Gyrohammer/KGM/docs/hardware.md

## [Raspi Camera](https://www.printables.com/model/389706-anycubic-kobra-go-camera-mount){target=_blank}
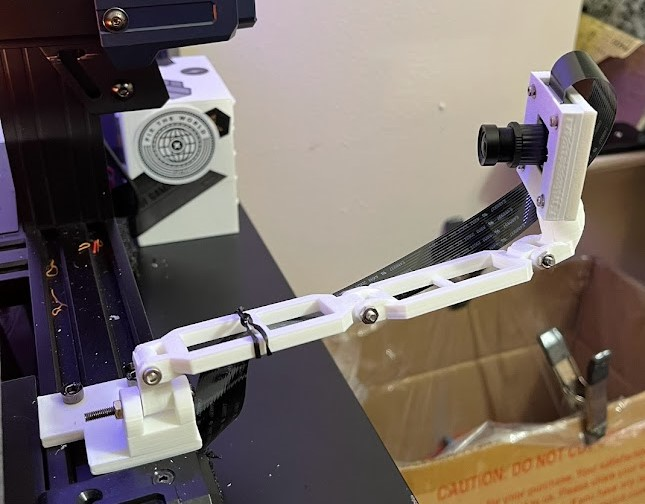
[picture p1: docs/assets/camera.jpg]
Raspi Camera


## [Hero Me Gen. 7.1](https://www.printables.com/model/39322-hero-me-gen6-master-suite){target=_blank}
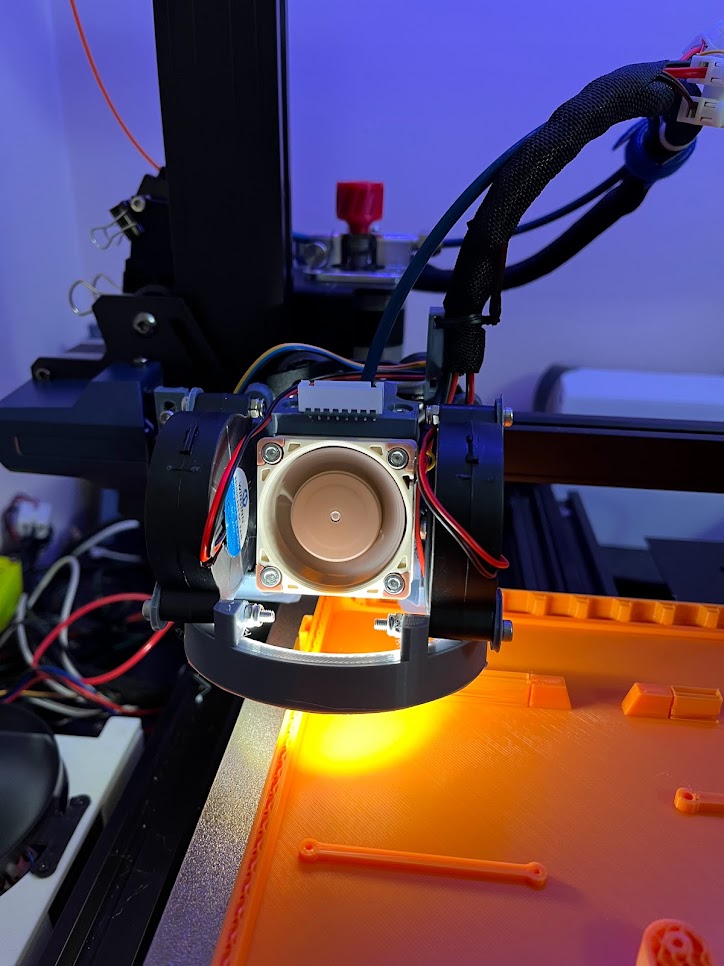
[picture p2: docs/assets/heromeg7.1.jpg]
HMG7.1


## [BTT SKR 3](https://www.printables.com/model/389719-btt-skr3-case){target=_blank}
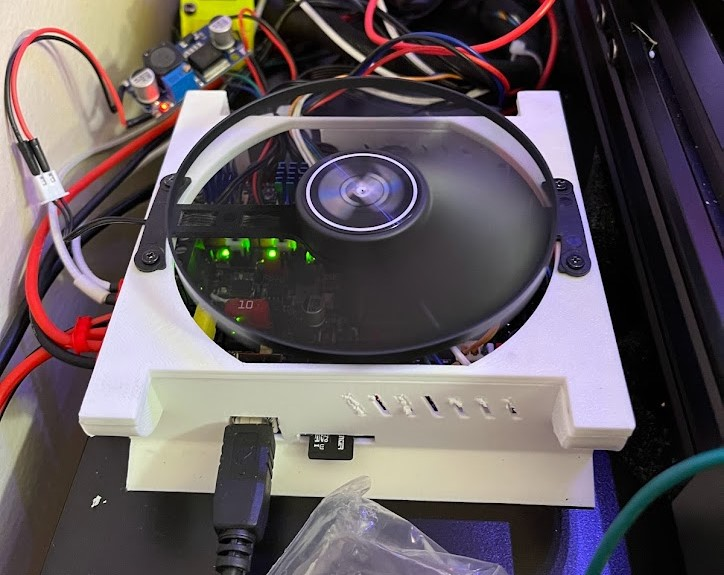
[picture p3: docs/assets/motherboard.jpg]
motherboard case
