Gyrohammer/KGM/docs/index.md

# Welcome to My Mod Page!
## Intro

I decided to make a website to showcase my Kobra Go and the mods I've performed to it.

I'll be keeping this up to date to the best of my ability!

## **Recommended Order of Modifications**

### [Klipper](software/klipper.md)
This upgrade can be performed on a stock machine, making it one of the most cost efficient upgrades.
### [Direct Drive](mods/orbiter-2.md)
Cost and time will be the biggest sinks here, as wires will need to be extended and crimped. The cost also increases as a DD extruder must be obtained. 
### [Enclosure](mods/enclosure.md)
The highest cost and time sink. Lots of components will be needed and lots of wires extended.

## Current Status
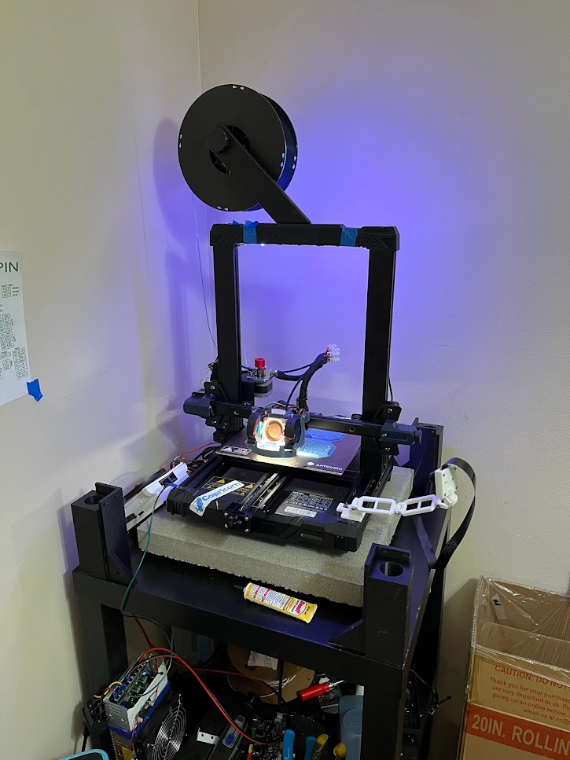
[picture p4: docs/assets/feb23setup.jpg]
January '24 Setup


* Software: 
    ```Klipper```
* Mainboard:
    ```BTT SKR 3.0 + Raspi 4 4GB```
* Drivers:
    ```TMC2209```
* Stepper Motors:
    ```Stock```
* Hotend:
    ```Microswiss```
* Extruder:
    ```Orbiter 2.0```
* Printhead:
    ```Endli Orbiter 2.0```
* Cooling: 
    
    ```Arctic S4023-15k```

    ```Single 5015```
