Gyrohammer/KGM/docs/mods/belted-z-axis.md

# NOTE: THESE LINKS ARE PART OF THE AMAZON ASSOCIATES PROGRAM OF WHICH I AM IN. BY USING THESE LINKS TO PURCHASE PRODUCTS, YOU HELP ME EARN A SMALL COMISSION. THANKS!

# [Belted Z-Axis](https://kevinakasam.com/belt-driven-ender-3/){target=_blank}

This belted z-axis mod from Kevin is one of the more involved upgrades one can perform on a Kobra Go. It involves replacing the two rear brackets with some 3D printed ones which then have to be modified to fit the eccentric nut that the Go uses. The crossbar of the frame must also be removed and replaced with a standard 2020 aluminum extrusion. 

## Replacing the Crossbar

In order to replace the crossbar one must obtain some [2020 aluminum extrusion](https://amzn.to/4ayI8oi){target=_blank}. A single extrusion must then be cut to 330mm in length, and holes drilled through the top to secure it onto the frame. I used a drill press at work, and made [a stencil](../assets/crossbarmod-stencil.stl) to get the holes correct.

<!-- Import the component -->
<script type="module" src="../assets/javascript/model-viewer.js"></script>

<!-- Use it like any other HTML element -->
<model-viewer style="width: 100%; height: 400px; top: 0px;  position: sticky" alt="Crossbar Stencil" auto-rotate src="../assets/3d-models/crossbar-stencil.glb" ar environment-image="" poster="" shadow-intensity="1" camera-controls touch-action="" loading="eager" render-scale=0.5 ></model-viewer>

After this modification is complete, just follow the steps outlined in the guide on Kevins website! Oh also be sure to order one of the kits from the vendors he recommends! I ordered mine from DFH and had a good experience.
