Gyrohammer/KGM/docs/assets/dialgaugebracket2.jpg

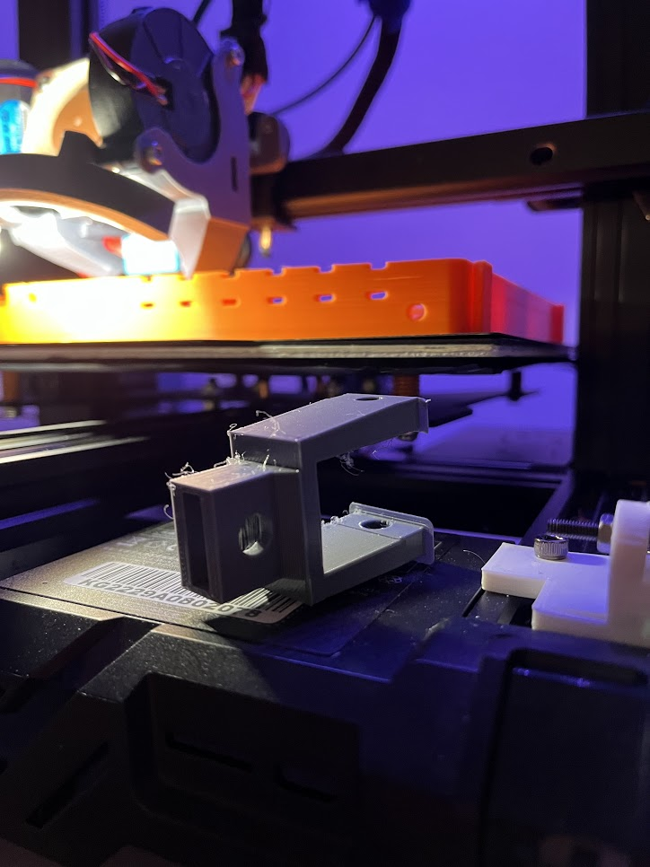
docs/assets/dialgaugebracket2.jpg
