Gyrohammer/KGM/docs/assets/dialgaugebracket3.jpg

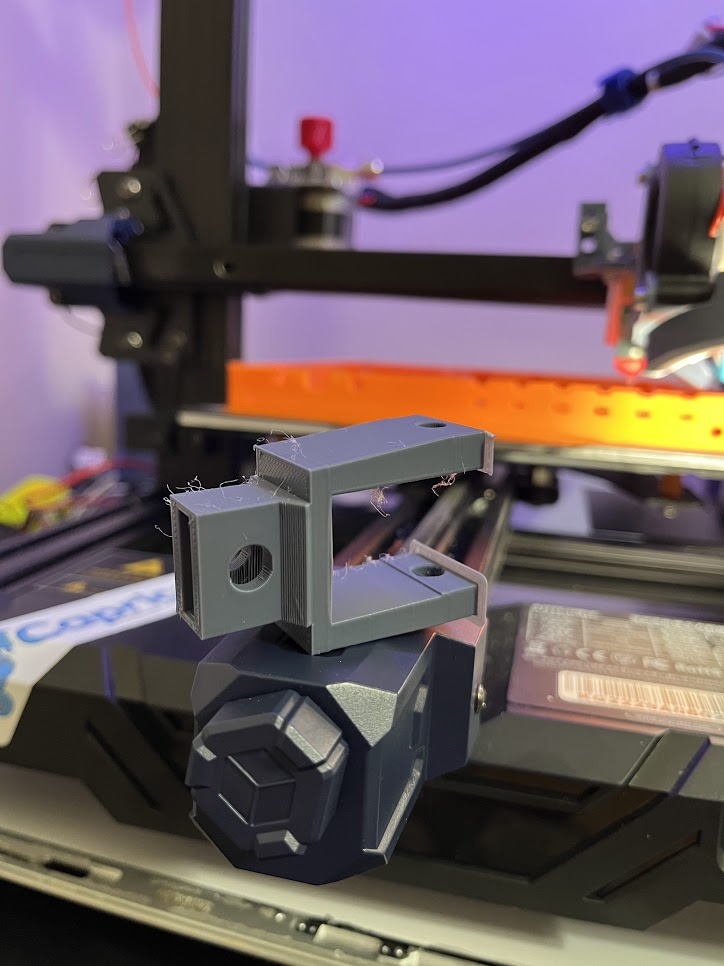
docs/assets/dialgaugebracket3.jpg
