Gyrohammer/KGM/docs/assets/dialgaugebracket.jpg

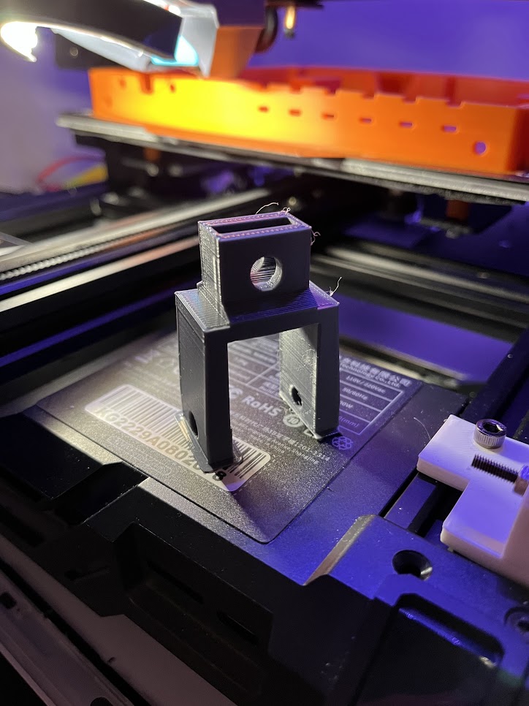
docs/assets/dialgaugebracket.jpg
