Gyrohammer/KGM/docs/assets/first_benchy.jpg

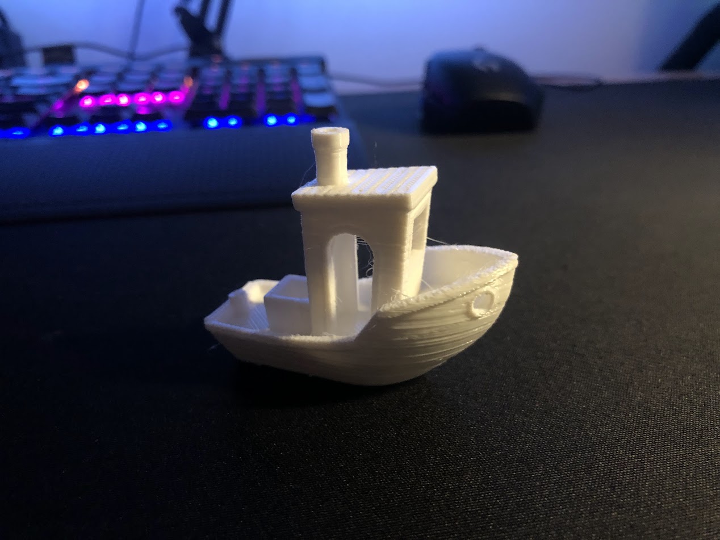
docs/assets/first_benchy.jpg
