Gyrohammer/KGM/docs/mods/assets/hmg7.jpg

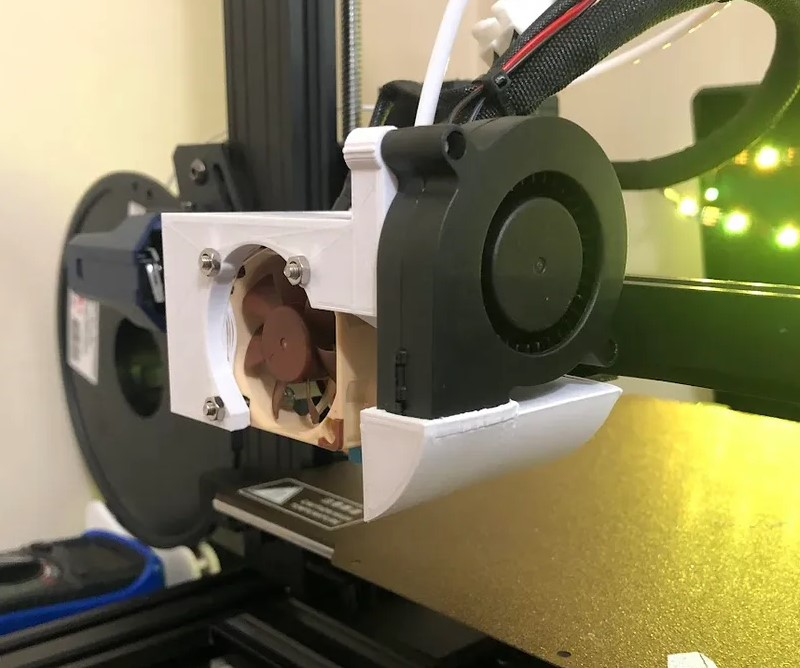
docs/mods/assets/hmg7.jpg
