Gyrohammer/KGM/site/accessories/assets/heromeg7.1.jpg

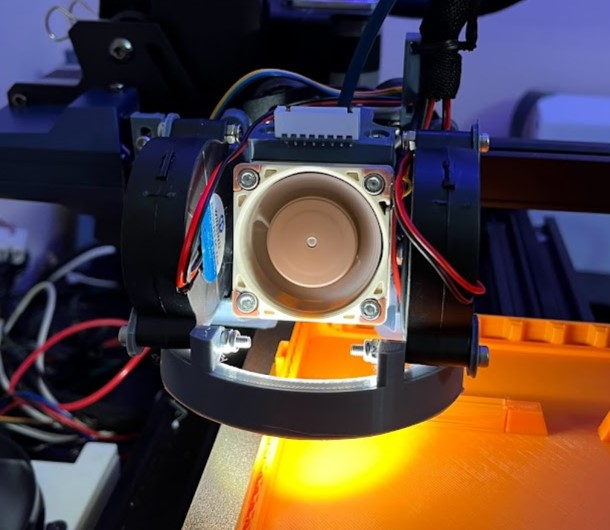
site/accessories/assets/heromeg7.1.jpg
