Gyrohammer/KGM/site/assets/bench_new_front_iso.jpg

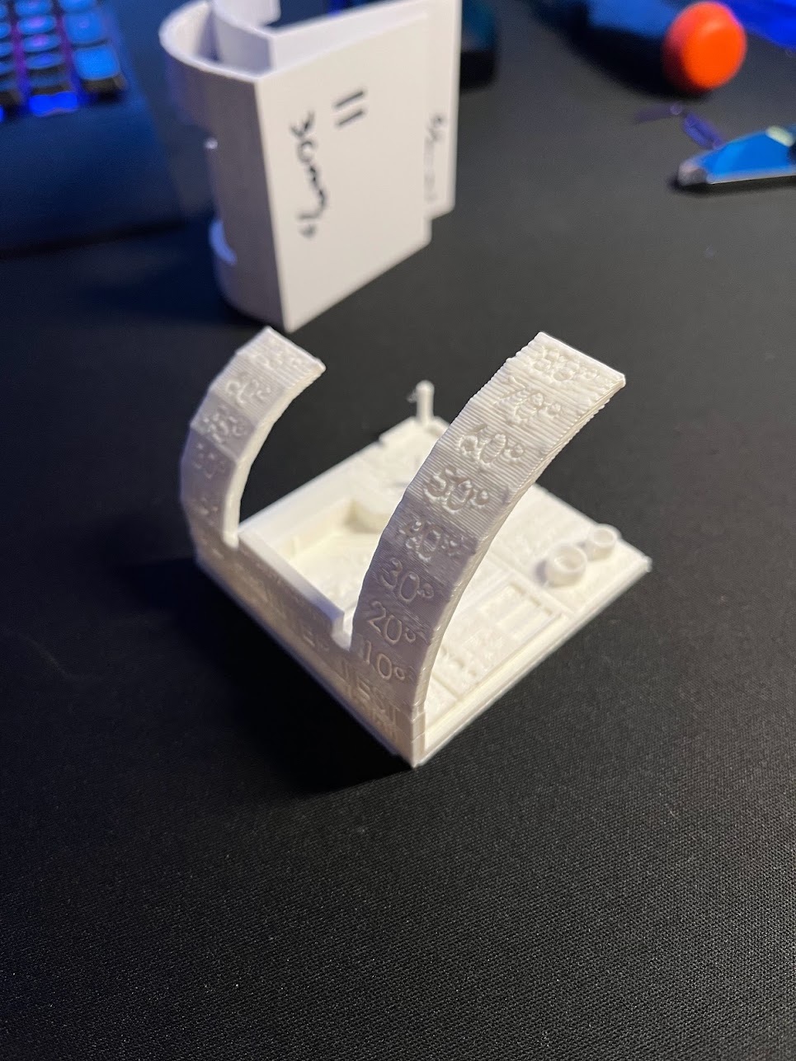
site/assets/bench_new_front_iso.jpg
