Gyrohammer/KGM/docs/assets/3d-models/enclosure/Vents/Exhaust Filtered/Main Body.stl

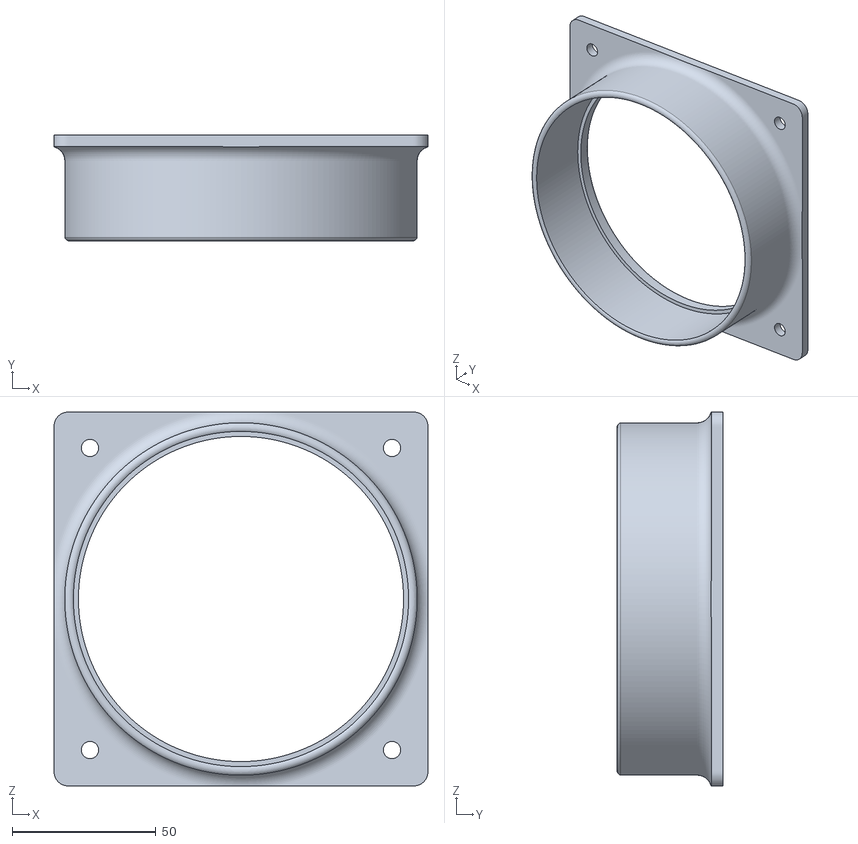
[picture p16: CAD file, 2023-12-27]
docs/assets/3d-models/enclosure/Vents/Exhaust Filtered/Main Body.stl
130.0 x 36.9 x 130.0
