Gyrohammer/KGM/docs/assets/3d-models/enclosure/Handles-Accessories/Control Panel.stl

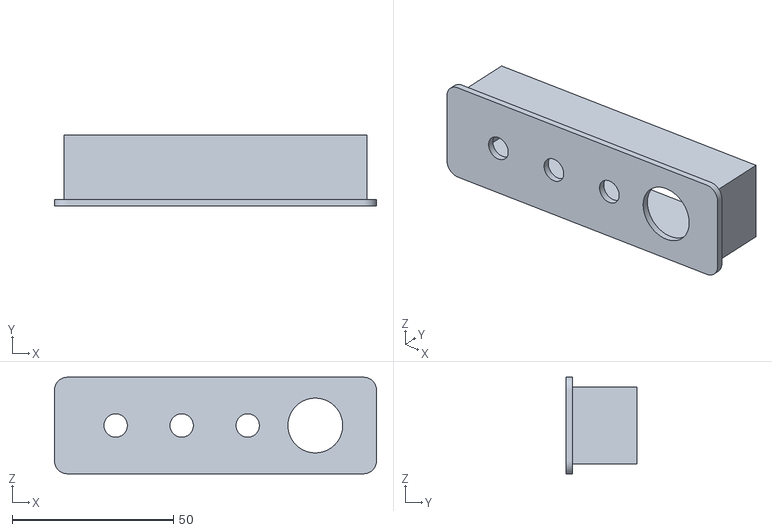
[picture p17: CAD file, 2023-12-27]
docs/assets/3d-models/enclosure/Handles-Accessories/Control Panel.stl
100.0 x 22.0 x 30.0
