Gyrohammer/KGM/docs/assets/3d-models/enclosure/Legs/Lower Front/Right Hinge.stl

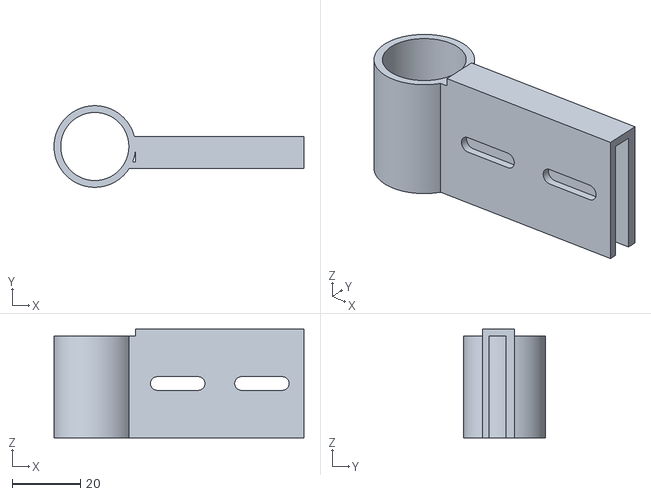
[picture p18: CAD file, 2023-12-27]
docs/assets/3d-models/enclosure/Legs/Lower Front/Right Hinge.stl
73.5 x 24.0 x 32.0
