Gyrohammer/KGM/docs/assets/3d-models/enclosure/Legs/Lower Rear/Left.stl

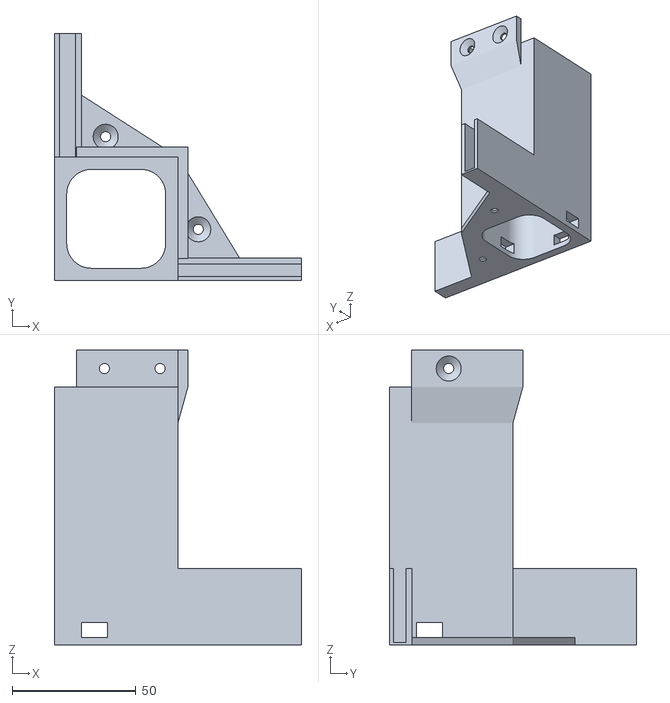
[picture p19: CAD file, 2023-12-27]
docs/assets/3d-models/enclosure/Legs/Lower Rear/Left.stl
100.0 x 100.0 x 119.3
