Gyrohammer/KGM/docs/assets/3d-models/enclosure/Legs/Upper Front/Right Leg.stl

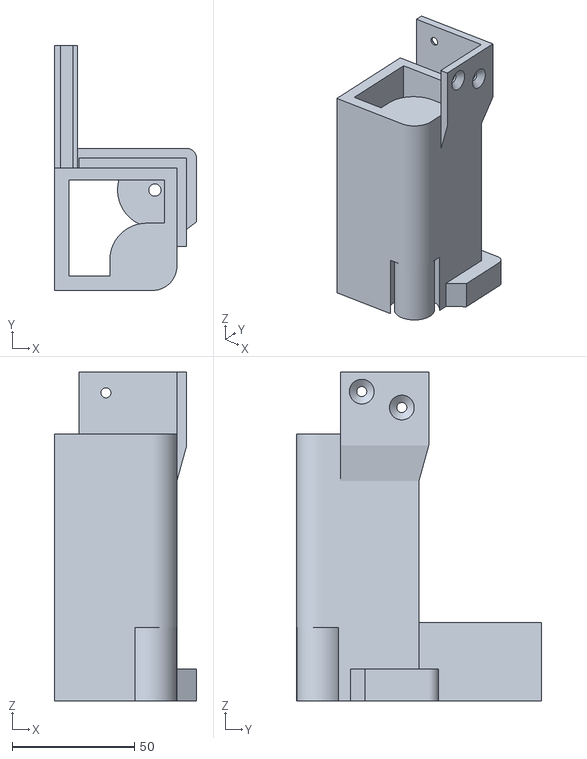
[picture p20: CAD file, 2023-12-27]
docs/assets/3d-models/enclosure/Legs/Upper Front/Right Leg.stl
58.0 x 100.0 x 134.3
