Gyrohammer/KGM/docs/assets/3d-models/enclosure/Legs/Upper Rear/Right.stl

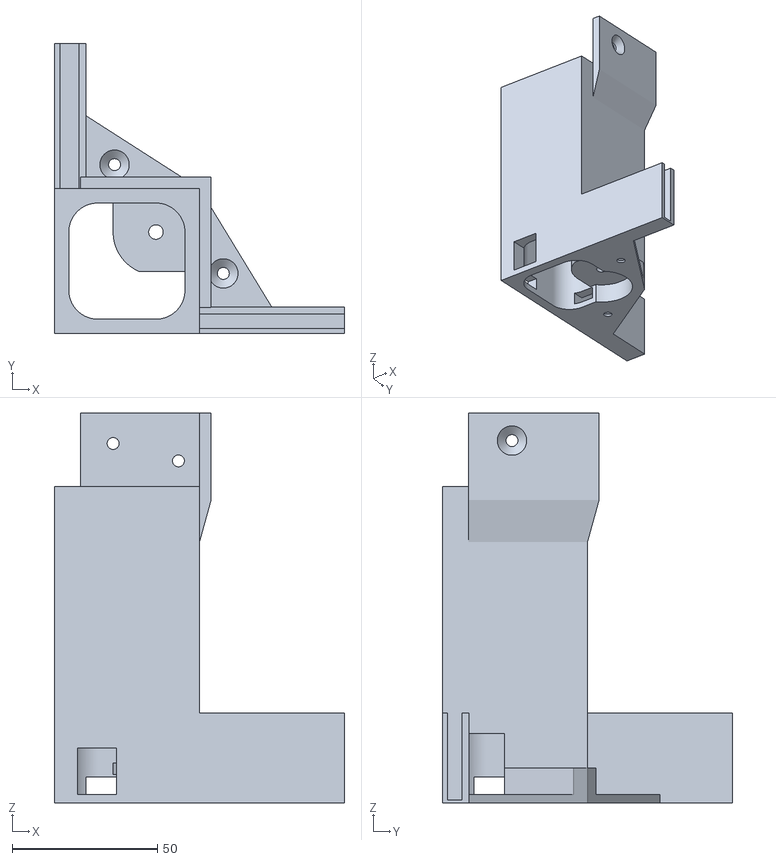
[picture p21: CAD file, 2023-12-27]
docs/assets/3d-models/enclosure/Legs/Upper Rear/Right.stl
100.0 x 100.0 x 134.3
