Gyrohammer/KGM/docs/assets/3d-models/enclosure/Vents/Exhaust Non-Filtered/Tubing Adaptor.stl

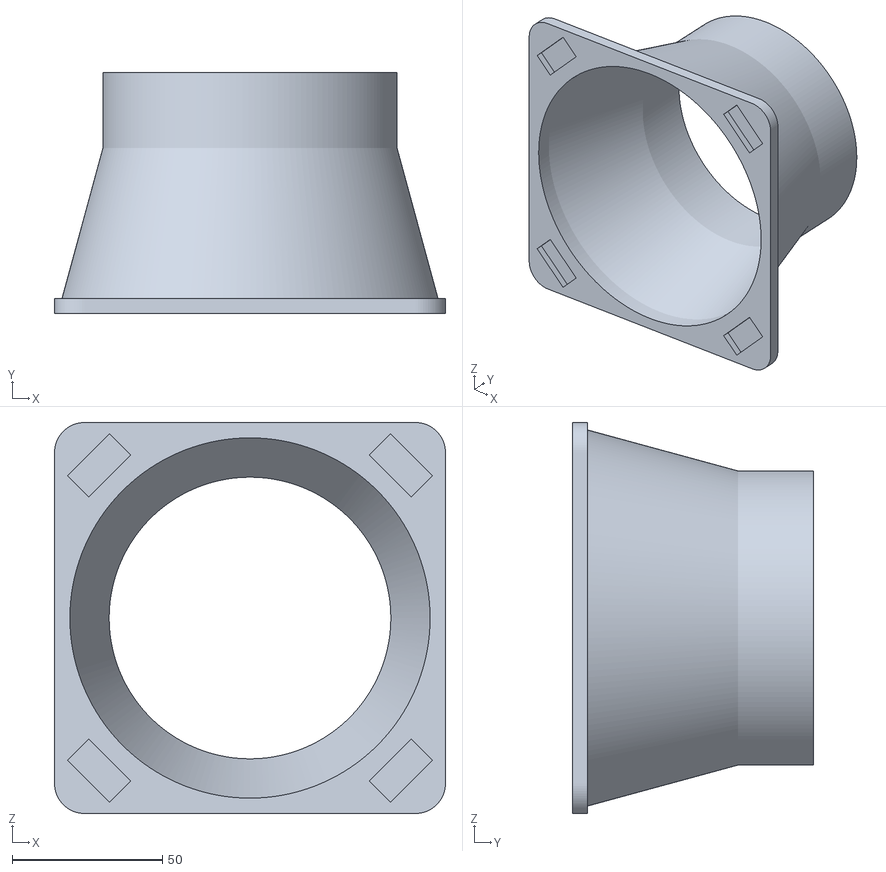
[picture p22: CAD file, 2023-12-27]
docs/assets/3d-models/enclosure/Vents/Exhaust Non-Filtered/Tubing Adaptor.stl
130.0 x 80.0 x 130.0
