Gyrohammer/KGM/docs/assets/crossbarmod-stencil.stl

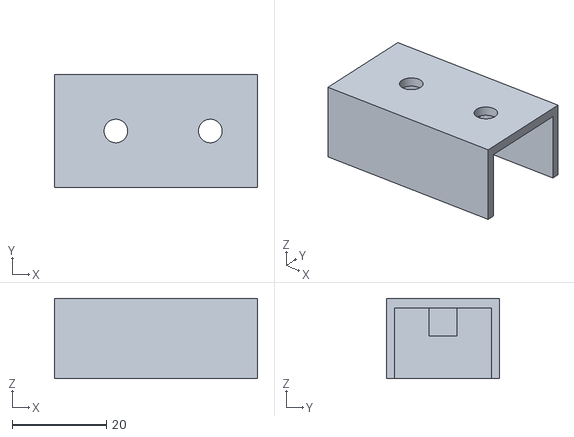
[picture p23: CAD file, 2023-12-26]
docs/assets/crossbarmod-stencil.stl
43.0 x 24.0 x 17.0
