Gyrohammer/KGM/docs/assets/3d-models/enclosure/Handles-Accessories/Door Handle Left.stl

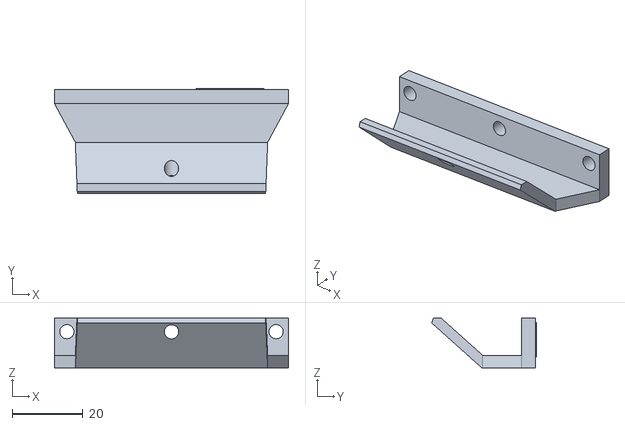
[picture p24: CAD file, 2023-12-27]
docs/assets/3d-models/enclosure/Handles-Accessories/Door Handle Left.stl
66.0 x 29.5 x 14.0
