Gyrohammer/KGM/docs/assets/3d-models/enclosure/Legs/Lower Front/Left Hinge.stl

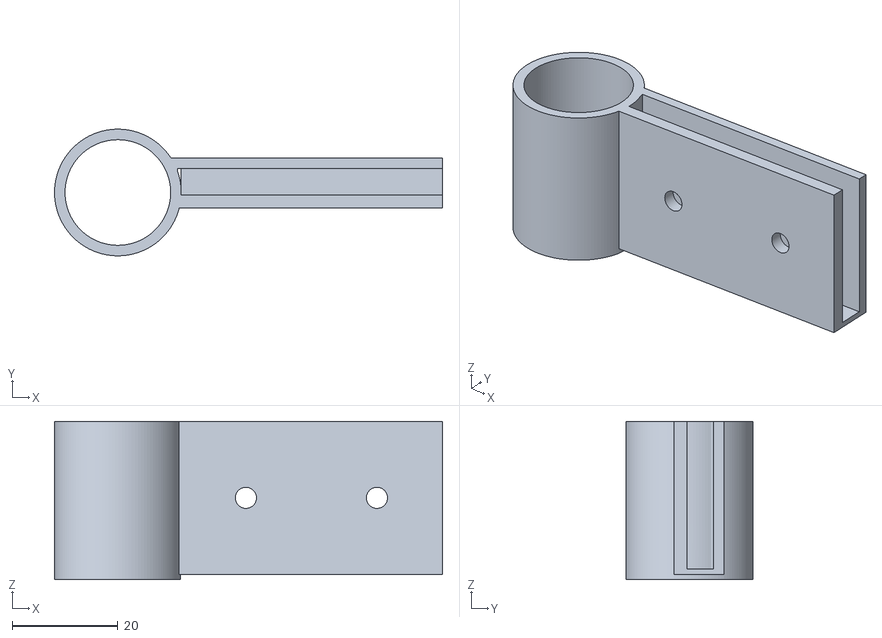
[picture p25: CAD file, 2023-12-27]
docs/assets/3d-models/enclosure/Legs/Lower Front/Left Hinge.stl
73.5 x 24.0 x 30.0
