Gyrohammer/KGM/docs/assets/3d-models/enclosure/Legs/Upper Rear/Left.stl

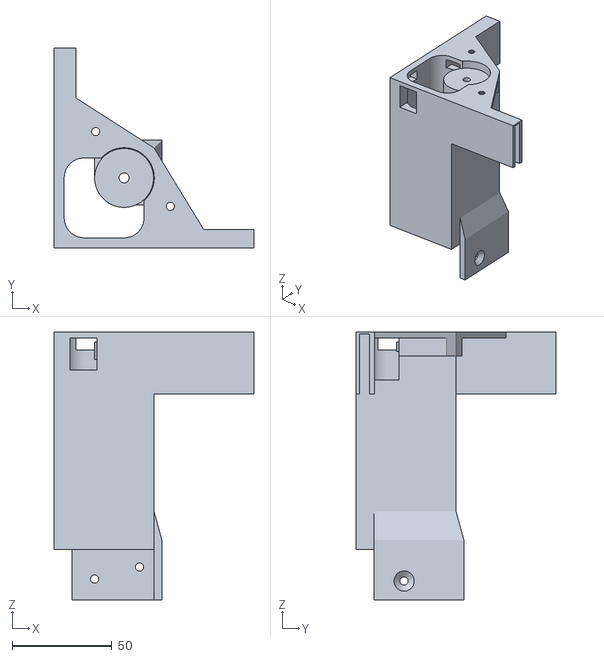
[picture p26: CAD file, 2023-12-27]
docs/assets/3d-models/enclosure/Legs/Upper Rear/Left.stl
100.0 x 100.0 x 134.3
