Gyrohammer/KGM/docs/assets/3d-models/enclosure/Vents/Exhaust Filtered/HEPA_Section.stl

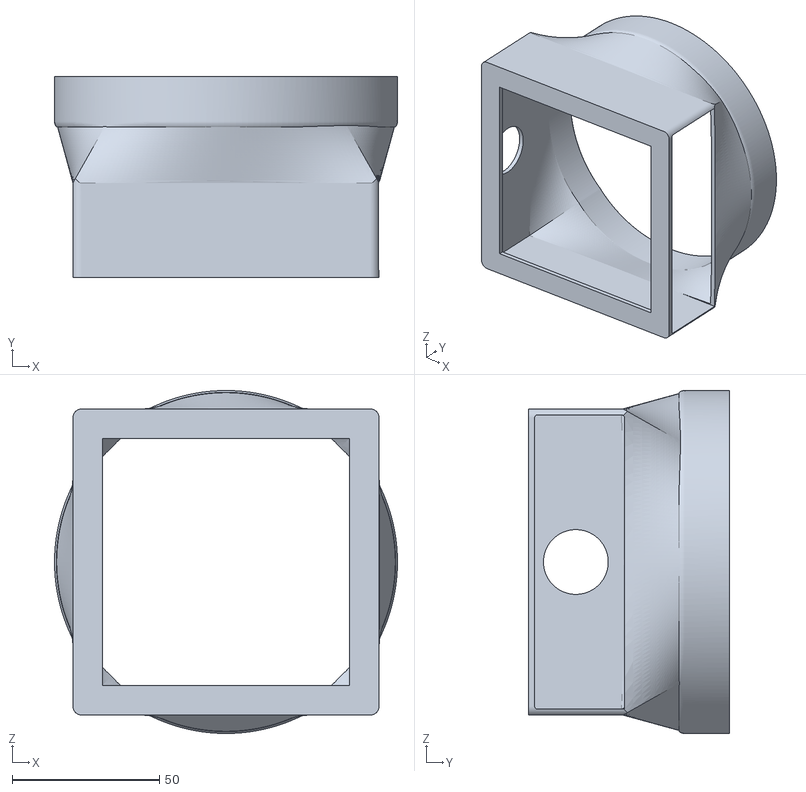
[picture p27: CAD file, 2023-12-27]
docs/assets/3d-models/enclosure/Vents/Exhaust Filtered/HEPA_Section.stl
116.5 x 68.1 x 116.5
