Gyrohammer/KGM/docs/assets/3d-models/enclosure/Vents/Exhaust Non-Filtered/Baseplate.stl

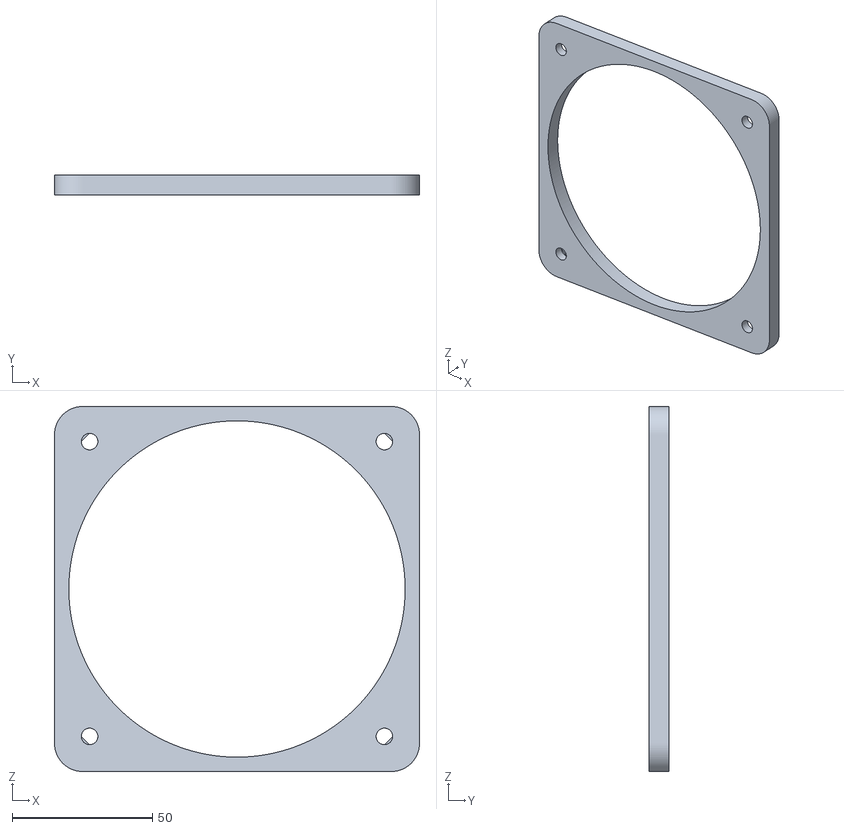
[picture p28: CAD file, 2023-12-27]
docs/assets/3d-models/enclosure/Vents/Exhaust Non-Filtered/Baseplate.stl
130.0 x 7.00 x 130.0
