Gyrohammer/KGM/docs/assets/3d-models/enclosure/Legs/Lower Front/Left Leg.stl

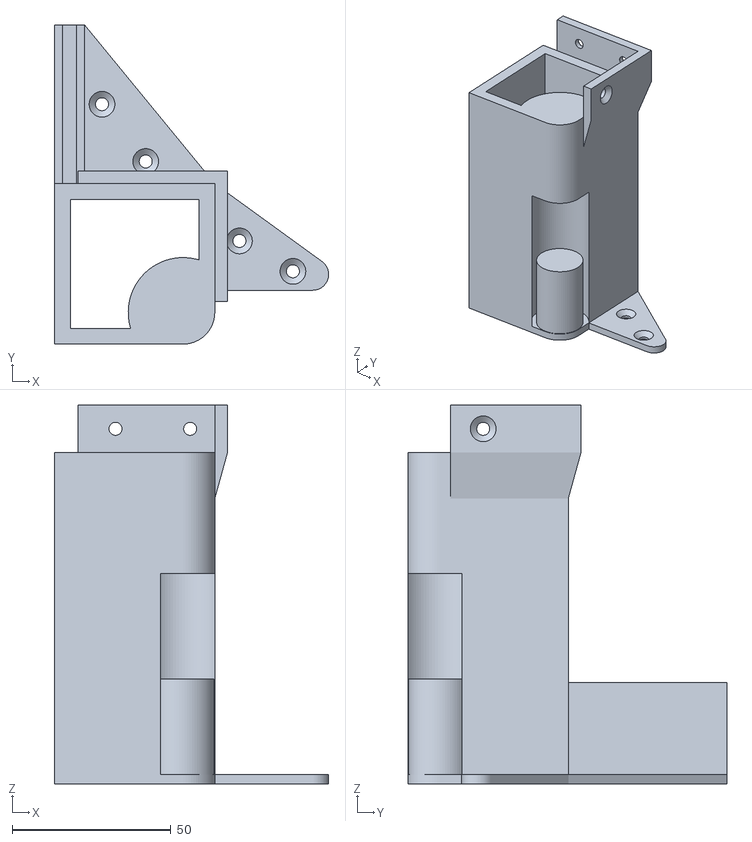
[picture p29: CAD file, 2023-12-27]
docs/assets/3d-models/enclosure/Legs/Lower Front/Left Leg.stl
86.3 x 100.5 x 119.3
