Gyrohammer/KGM/docs/assets/3d-models/enclosure/Vents/Exhaust Non-Filtered/Magnetic Lid.stl

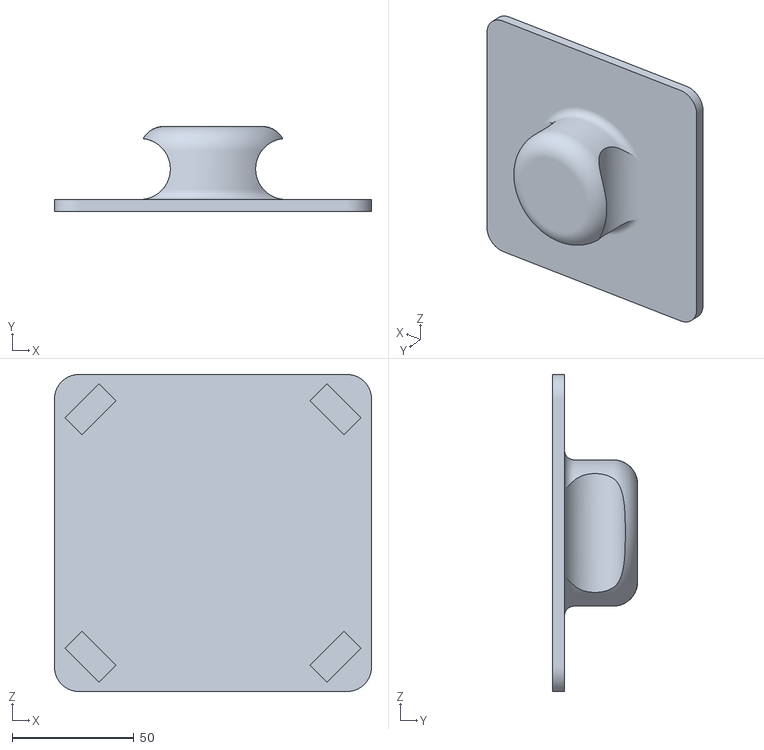
[picture p30: CAD file, 2023-12-27]
docs/assets/3d-models/enclosure/Vents/Exhaust Non-Filtered/Magnetic Lid.stl
130.0 x 35.0 x 130.0
