Gyrohammer/KGM/(list of files, cad)

Other CAD files:
docs/assets/3d-models/enclosure/Legs/Lower Rear/Right.stl
docs/assets/3d-models/enclosure/Legs/Upper Front/Left Hinge.stl
docs/assets/3d-models/enclosure/Legs/Upper Front/Left Leg.stl
docs/assets/3d-models/enclosure/Legs/Lower Front/Right Leg.stl
docs/assets/3d-models/enclosure/Legs/Upper Front/Right Hinge.stl
