Gyrohammer/KGM/docs/assets/original_setup.jpg

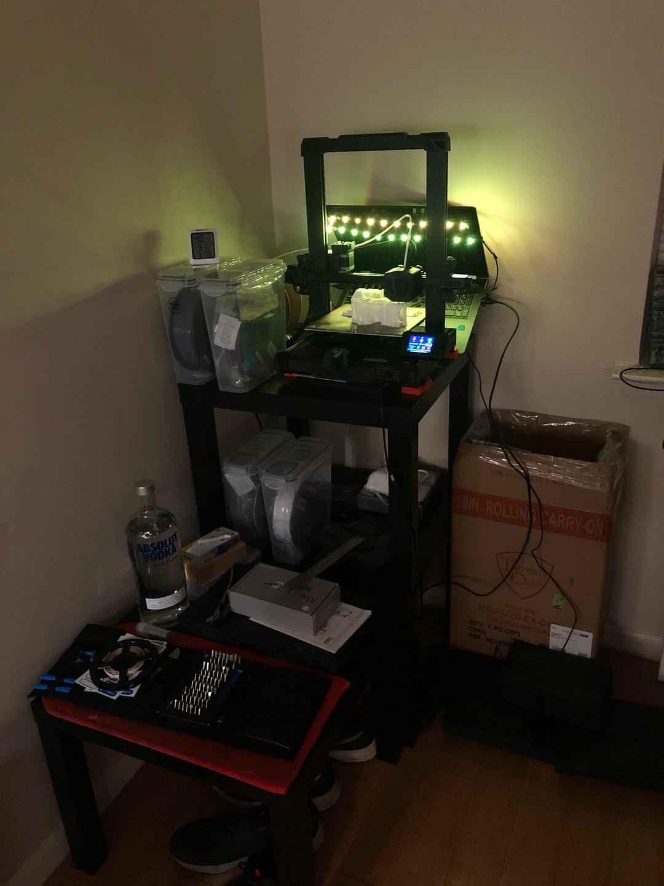
docs/assets/original_setup.jpg
