Gyrohammer/KGM/(commit log)

2023-12-26 reformat & rename pages
    [crossbarmod-stencil.stl]
2023-12-26 update enclosure and klipper pages
2023-12-26 update e3d nozzle link
2023-12-27 update enlcosure page
    [Baseplate.stl, Control Panel.stl, Door Handle Left.stl, Door Handle Right.stl, HEPA_Section.stl, Left Hinge.stl, Left Leg.stl, Left.stl]
2023-12-27 update enclosure page
2026-07-21 Add Amazon Associates program note to print-heads.md
    Added a note about Amazon Associates links to the document.
2026-07-21 Add Amazon Associates program note to enclosure.md
    Added a note about Amazon Associates program to the enclosure documentation.
2026-07-21 Add Amazon Associates program note to belted z-axis doc
    Added a note about Amazon Associates program and commissions.
2026-07-21 Add Amazon Associates program note to Arctic 40mm fan doc
    Added a note about Amazon Associates links for transparency.
2026-07-21 Fix formatting for START_PRINT macro in klipper.md
    Updated the formatting of the START_PRINT macro in klipper.md to ensure proper rendering.
